Moaske/Freenove-MultiRemote/enclosure/Universal-Remote_bottom-half.stl

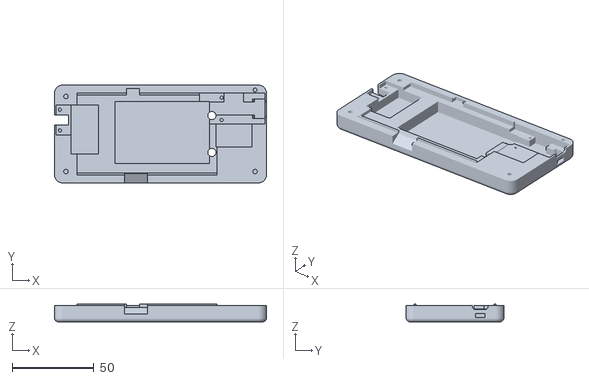
[picture p6: CAD file, 2026-11-09]
enclosure/Universal-Remote_bottom-half.stl
130.0 x 60.0 x 11.0
