Moaske/Freenove-MultiRemote/enclosure/Universal-Remote_top-half.stl

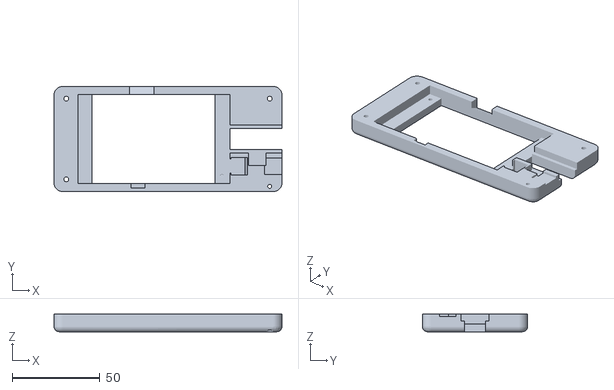
[picture p7: CAD file, 2026-11-09]
enclosure/Universal-Remote_top-half.stl
130.0 x 60.0 x 10.0
