Moaske/Freenove-MultiRemote/enclosure/Universal-Remote_insert.stl

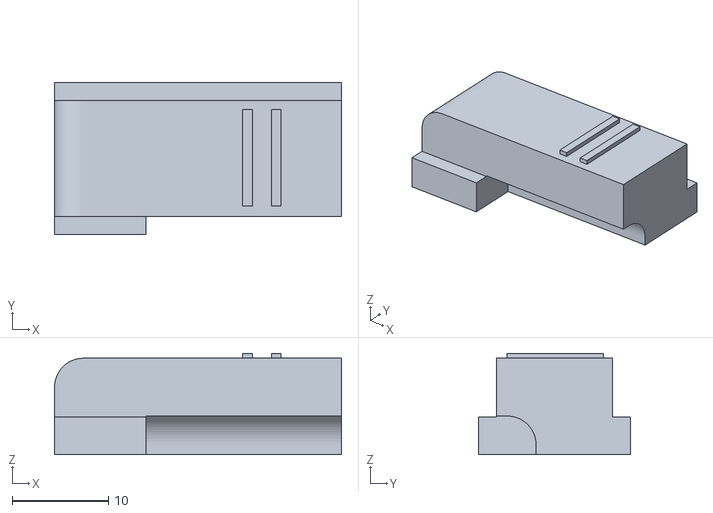
[picture p8: CAD file, 2026-11-09]
enclosure/Universal-Remote_insert.stl
29.8 x 15.8 x 10.5
