Moaske/Freenove-MultiRemote/(commit log)

2026-10-31 Firmware skeleton: screen, touch, IR from Flipper .ir files, battery, settings
    Claude-Session: https://claude.ai/code/session_01UVnDpuXkbLEPEy3t8jAnJy
    [battery.cpp, battery.h, board_setup.h, config.h, icons.cpp, icons.h, ir_codes.cpp, ir_codes.h]
2026-11-04 Battery: detect charger power from 4.25 V; show measured voltage in Settings
    One board read the charger's 4.5 V as under 4.35 V and showed 100%.
    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
2026-11-04 Bluetooth: media keys, track info and cover from a Windows tray app
    Firmware: BLE HID consumer control (play/pause, next, previous), battery
    level to Windows, a service the tray app writes title/artist/album/state
    and a 60x60 cover to; Bluetooth pairing screen with Forget; standby keeps
    the link, deep sleep after 30 min.
    tray/: .NET 8 tray app reading the Windows media session.
    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
2026-11-04 Fix touch dead after waking from sleep
    The touch library only read after a pen-interrupt edge; sleeping on that pin
    disabled the edge interrupt. Poll the XPT2046 instead, and release the wake
    pins from RTC mode after a deep-sleep wake.
    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
    [main.cpp, touch.cpp]
2026-11-06 Tray app: never force Bluetooth connections
    Keep one BluetoothLEDevice, wait for Windows to report the remote connected
    (it reconnects paired HID devices by itself), use the cached service list,
    and look again over the air at most once per connection. The old version
    retried uncached discovery every 10 s, which can upset other Bluetooth links.
    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
